Kevin-CE21/ESP32-S3-Multimedia-LED-PCB/Heart_LED_JLCPCB_BOM.xlsx

Designator | Quantity | Value | Manufacturer | Manufacturer Part | LCSC Part Number | Package / Footprint | Description
J3 | 1 | USB-C Power Only | GCT | USB4135-GF-A_6P_TopMnt_Horizontal | C5438410 | Connector_USB:USB_C_Receptacle_GCT_USB4135-GF-A_6P_TopMnt_Horizontal | USB-C receptacle, power only, 3 A
R1,R2 | 2 | 5.1kΩ |  |  | C23186 | Resistor_SMD:R_0603_1608Metric | USB-C CC pull-down resistors
R3,R4 | 2 | 3.9kΩ |  |  | C23018 | Resistor_SMD:R_0603_1608Metric | TLC5940 IREF resistors
C2 | 1 | 10µF 16V X5R | Murata | GRM21BR61C106KE15K | C15850 | Capacitor_SMD:C_0805_2012Metric | VBUS bulk/decoupling capacitor
C4,C5,C9,C10 | 4 | 100nF 50V X7R |  | CL10B104KB8NNND | C14663 | Capacitor_SMD:C_0603_1608Metric | Local decoupling capacitors
