Kevin-CE21/ESP32-S3-Multimedia-LED-PCB/Multimedia-LED-PCB.kicad_pcb

## KiCad design Multimedia-LED-PCB.kicad_pcb (2026-10-12)

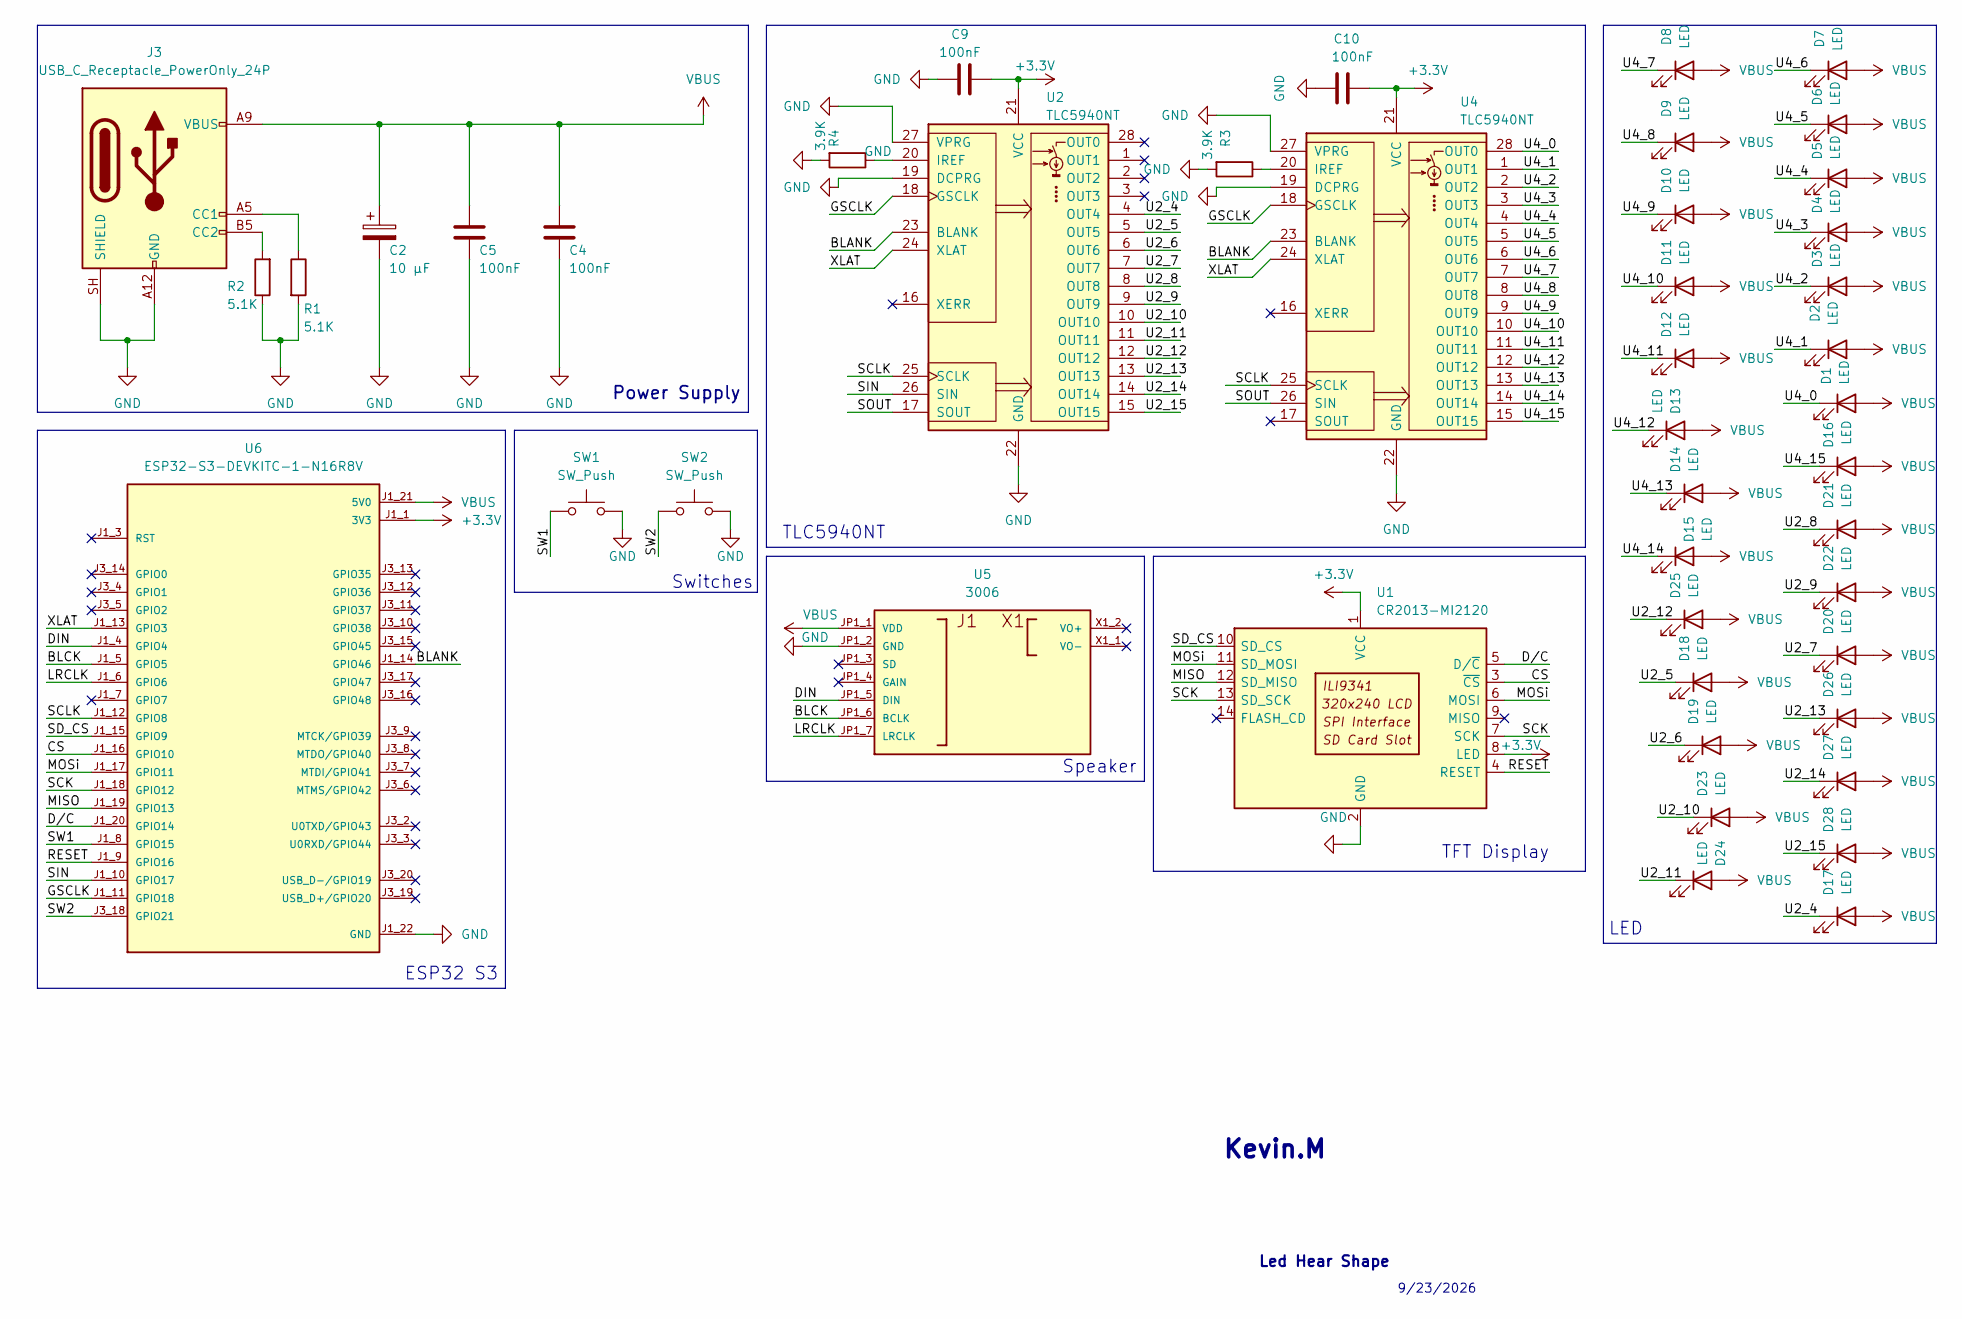
[picture p6: schematic Multimedia-LED-PCB.kicad_sch]

Parts:
C2: 10 µF; C_0805_2012Metric
C4, C5, C9, C10: 100nF; C_0603_1608Metric
D1, D2, D3, D4, D5, D6, D7, D8, D9, D10, D11, D12, D13, D14, D15, D16, D17, D18, D19, D20, D21, D22, D23, D24, D25, D26, D27, D28: LED; LED_D5.0mm
J3: USB_C_Receptacle_PowerOnly_24P; USB_C_Receptacle_GCT_USB4135-GF-A_6P_TopMnt_Horizontal; Part# C5438410
R1, R2: 5.1K; R_0603_1608Metric
R3, R4: 3.9K; R_0603_1608Metric
SW1, SW2: SW_Push; SW_PUSH-12mm
U1: CR2013-MI2120
U2, U4: TLC5940NT; DIP-28_W7.62mm
U5: 3006; MODULE_3006; PARTREV A
U6: ESP32-S3-DEVKITC-1-N16R8V; XCVR_ESP32-S3-DEVKITC-1-N16R8V; PARTREV 1.1

Connections:
+3.3V: C9.2, C10.2, U1.1 (VCC), U1.8 (LED), U2.21 (VCC), U4.21 (VCC), U6.J1_1 (3V3), U6.J1_2 (3V3)
/BLANK: U2.23 (BLANK), U4.23 (BLANK), U6.J1_14 (GPIO46)
/BLCK: U5.JP1_6 (BCLK), U6.J1_5 (GPIO5)
/CS: U1.3 (~CS), U6.J1_16 (GPIO10)
/DIN: U5.JP1_5 (DIN), U6.J1_4 (GPIO4)
/D/C: U1.5 (D/~C), U6.J1_20 (GPIO14)
/GSCLK: U2.18 (GSCLK), U4.18 (GSCLK), U6.J1_11 (GPIO18)
/LRCLK: U5.JP1_7 (LRCLK), U6.J1_6 (GPIO6)
/MISO: U1.12 (SD_MISO), U6.J1_19 (GPIO13)
/MOSi: U1.6 (MOSI), U1.11 (SD_MOSI), U6.J1_17 (GPIO11)
/RESET: U1.4 (RESET), U6.J1_9 (GPIO16)
/SCK: U1.7 (SCK), U1.13 (SD_SCK), U6.J1_18 (GPIO12)
/SCLK: U2.25 (SCLK), U4.25 (SCLK), U6.J1_12 (GPIO8)
/SD_CS: U1.10 (SD_CS), U6.J1_15 (GPIO9)
/SIN: U2.26 (SIN), U6.J1_10 (GPIO17)
/SOUT: U2.17 (SOUT), U4.26 (SIN)
/SW1: SW1.1, U6.J1_8 (GPIO15)
/SW2: SW2.1, U6.J3_18 (GPIO21)
/U2_4: D17.1 (K), U2.4 (OUT4)
/U2_5: D18.1 (K), U2.5 (OUT5)
/U2_6: D19.1 (K), U2.6 (OUT6)
/U2_7: D20.1 (K), U2.7 (OUT7)
/U2_8: D21.1 (K), U2.8 (OUT8)
/U2_9: D22.1 (K), U2.9 (OUT9)
/U2_10: D23.1 (K), U2.10 (OUT10)
/U2_11: D24.1 (K), U2.11 (OUT11)
/U2_12: D25.1 (K), U2.12 (OUT12)
/U2_13: D26.1 (K), U2.13 (OUT13)
/U2_14: D27.1 (K), U2.14 (OUT14)
/U2_15: D28.1 (K), U2.15 (OUT15)
/U4_0: D1.1 (K), U4.28 (OUT0)
/U4_1: D2.1 (K), U4.1 (OUT1)
/U4_2: D3.1 (K), U4.2 (OUT2)
/U4_3: D4.1 (K), U4.3 (OUT3)
/U4_4: D5.1 (K), U4.4 (OUT4)
/U4_5: D6.1 (K), U4.5 (OUT5)
/U4_6: D7.1 (K), U4.6 (OUT6)
/U4_7: D8.1 (K), U4.7 (OUT7)
/U4_8: D9.1 (K), U4.8 (OUT8)
/U4_9: D10.1 (K), U4.9 (OUT9)
/U4_10: D11.1 (K), U4.10 (OUT10)
/U4_11: D12.1 (K), U4.11 (OUT11)
/U4_12: D13.1 (K), U4.12 (OUT12)
/U4_13: D14.1 (K), U4.13 (OUT13)
/U4_14: D15.1 (K), U4.14 (OUT14)
/U4_15: D16.1 (K), U4.15 (OUT15)
/XLAT: U2.24 (XLAT), U4.24 (XLAT), U6.J1_13 (GPIO3)
GND: C2.2, C4.2, C5.2, C9.1, C10.1, J3.A1 (GND), J3.A12 (GND), J3.B1 (GND), J3.B12 (GND), J3.SH (SHIELD), R1.2, R2.1, R3.2, R4.2, SW1.2, SW2.2, U1.2 (GND), U2.19 (DCPRG), U2.22 (GND), U2.27 (VPRG), U4.19 (DCPRG), U4.22 (GND), U4.27 (VPRG), U5.JP1_2 (GND), U6.J1_22 (GND), U6.J3_1 (GND), U6.J3_21 (GND), U6.J3_22 (GND)
unnamed: J3.A5 (CC1), R1.1
unnamed: J3.B5 (CC2), R2.2
unnamed: R4.1, U2.20 (IREF)
unnamed: R3.1, U4.20 (IREF)
VBUS: C2.1, C4.1, C5.1, D1.2 (A), D2.2 (A), D3.2 (A), D4.2 (A), D5.2 (A), D6.2 (A), D7.2 (A), D8.2 (A), D9.2 (A), D10.2 (A), D11.2 (A), D12.2 (A), D13.2 (A), D14.2 (A), D15.2 (A), D16.2 (A), D17.2 (A), D18.2 (A), D19.2 (A), D20.2 (A), D21.2 (A), D22.2 (A), D23.2 (A), D24.2 (A), D25.2 (A), D26.2 (A), D27.2 (A), D28.2 (A), J3.A4 (VBUS), J3.A9 (VBUS), J3.B4 (VBUS), J3.B9 (VBUS), U5.JP1_1 (VDD), U6.J1_21 (5V0)

Notes on the sheet:
Led Hear Shape
LED
TLC5940NT
Kevin.M
9/23/2026
TFT Display
Speaker
Power Supply
Switches
ESP32 S3

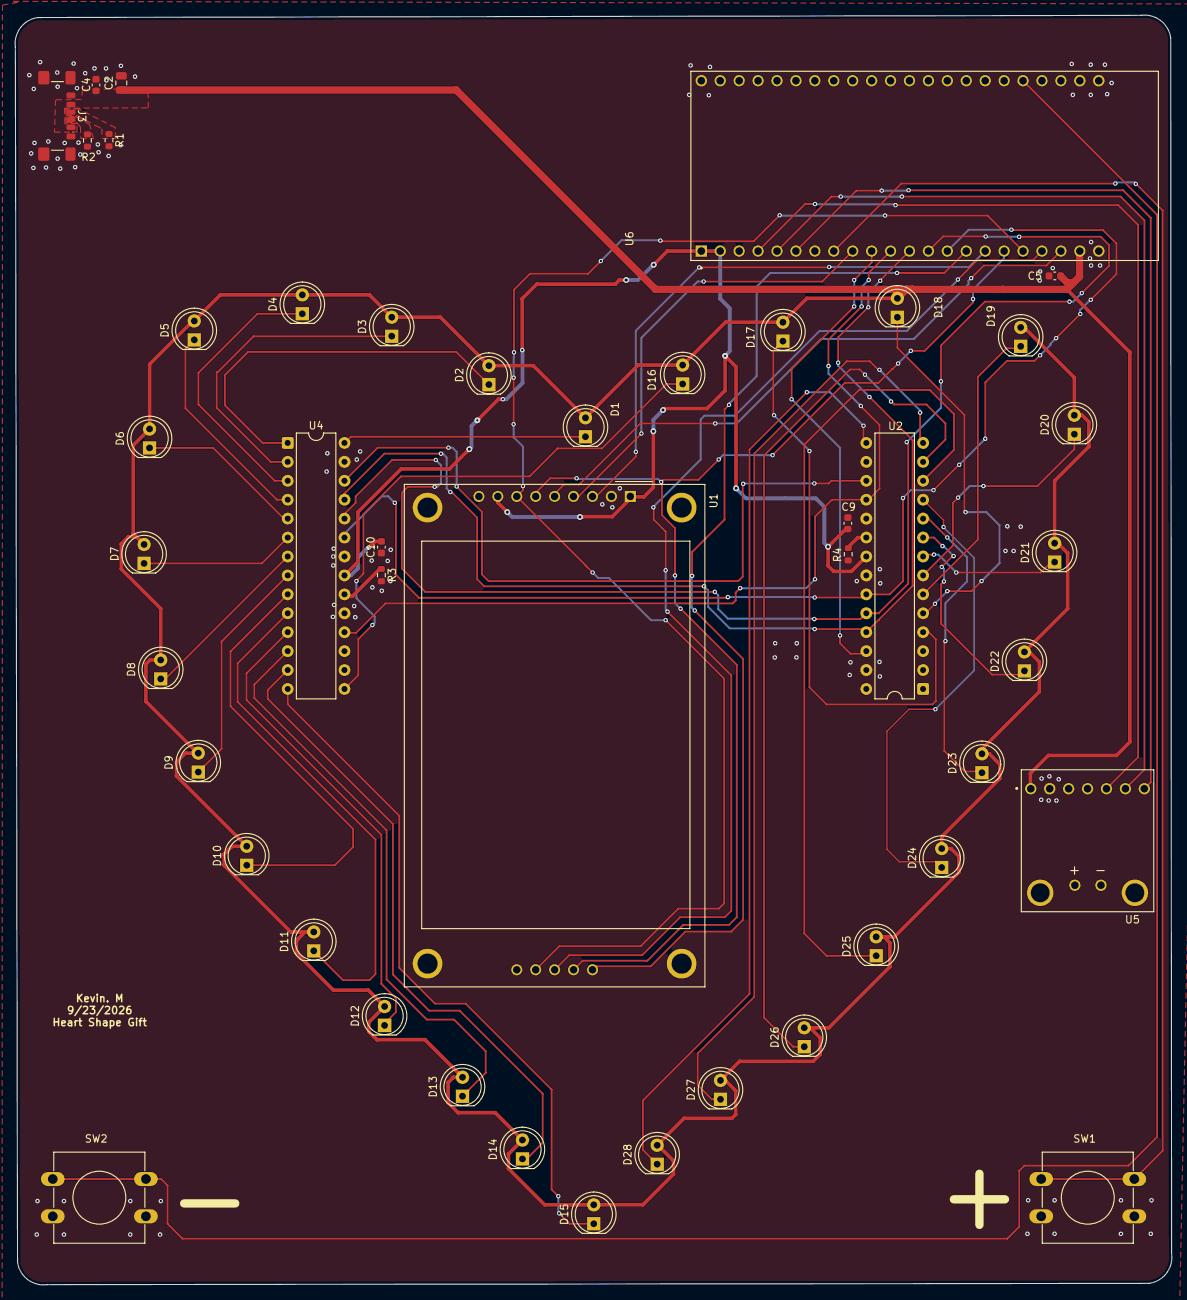
[picture p7: board Multimedia-LED-PCB.kicad_pcb from above]

Board: 2 copper layers, 155.2 x 170.4 mm, 45 parts (0 on the bottom side), 53 nets.
